Caller890/STM32H747IGT6-Custom-Development-Board/Gerber/README.md

Gerber fabrication files for STM32H747IGT6 Development Board
