Caller890/STM32H747IGT6-Custom-Development-Board/images/board_front.png

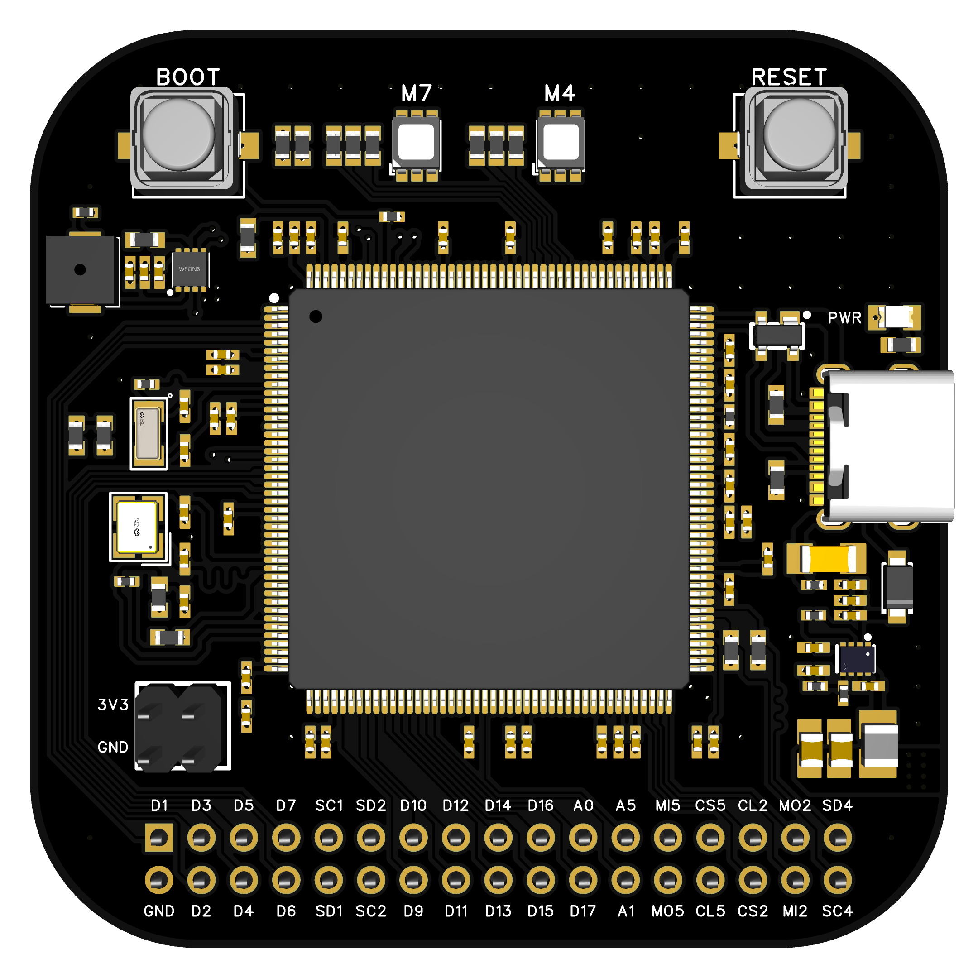
images/board_front.png
