Caller890/STM32H747IGT6-Custom-Development-Board/images/board_rear.png

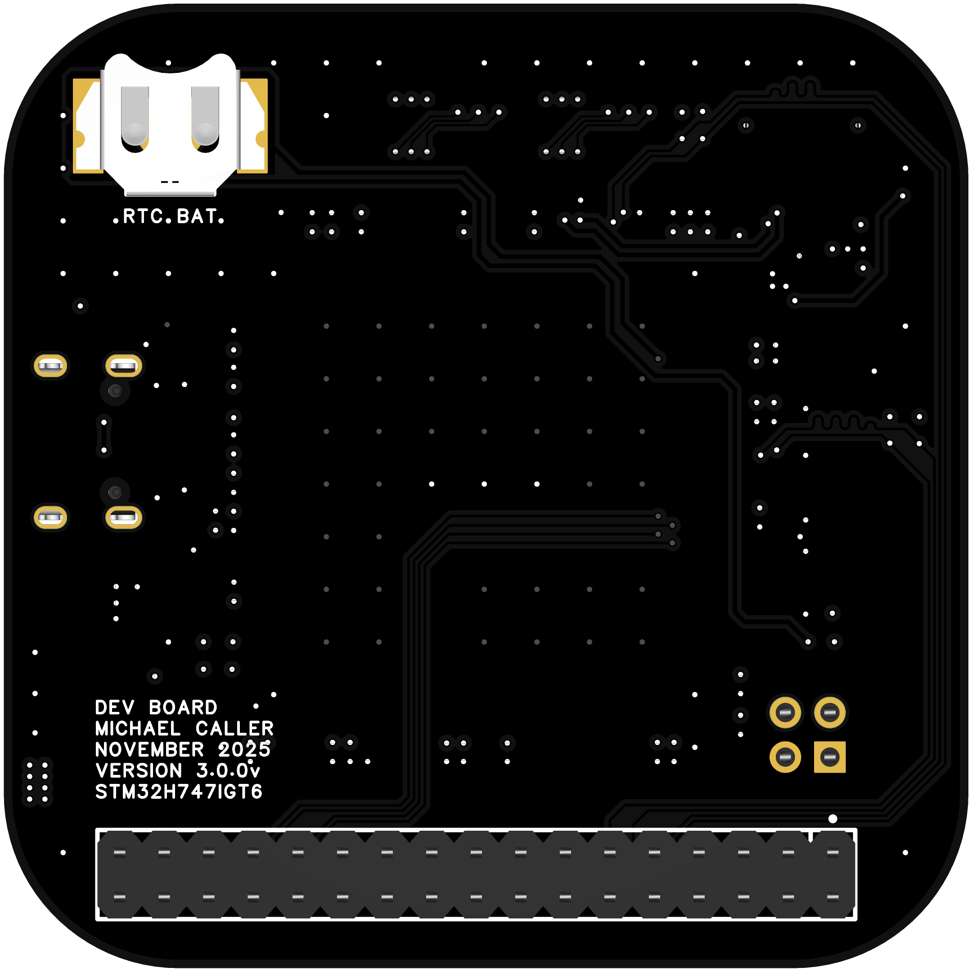
images/board_rear.png
