Caller890/STM32H747IGT6-Custom-Development-Board/images/gerber_front.png

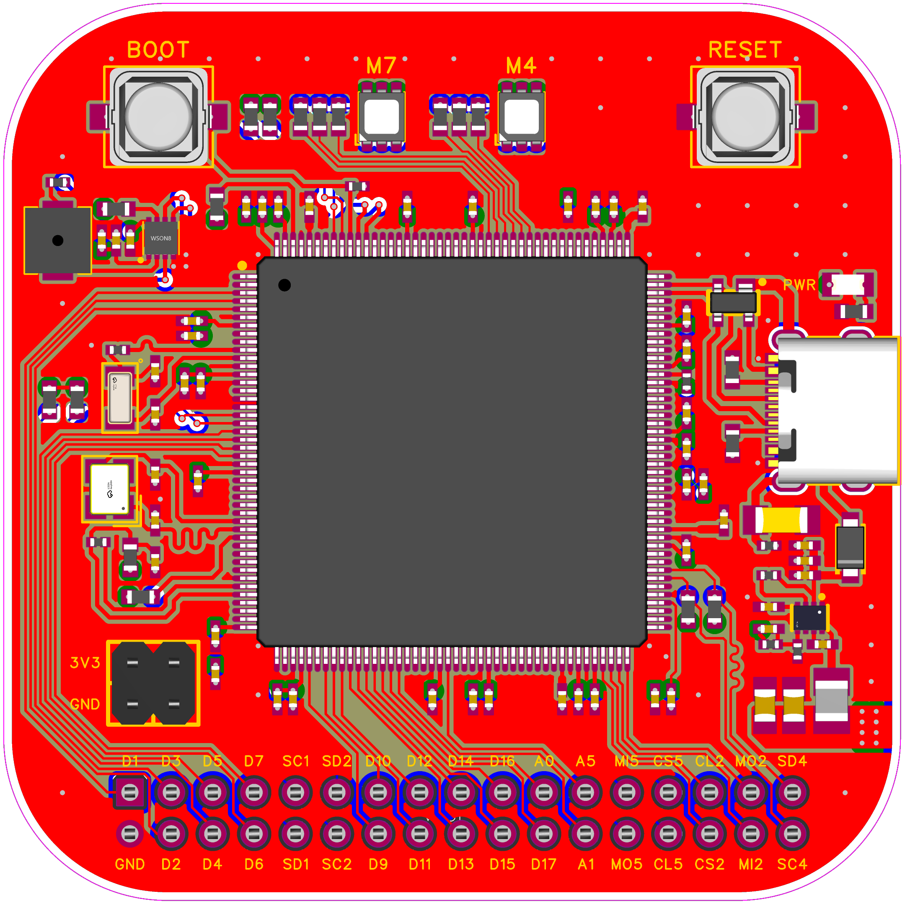
images/gerber_front.png
