Caller890/STM32H747IGT6-Custom-Development-Board/images/gerber_rear.png

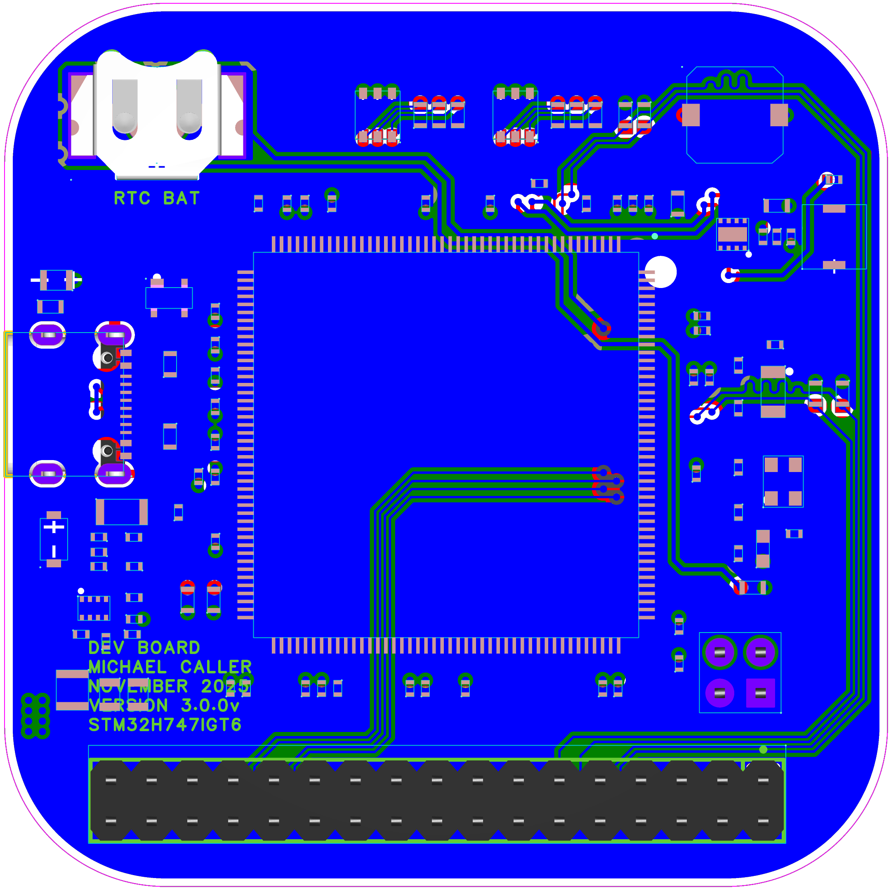
images/gerber_rear.png
