Caller890/STM32H747IGT6-Custom-Development-Board/images/normal_view.png

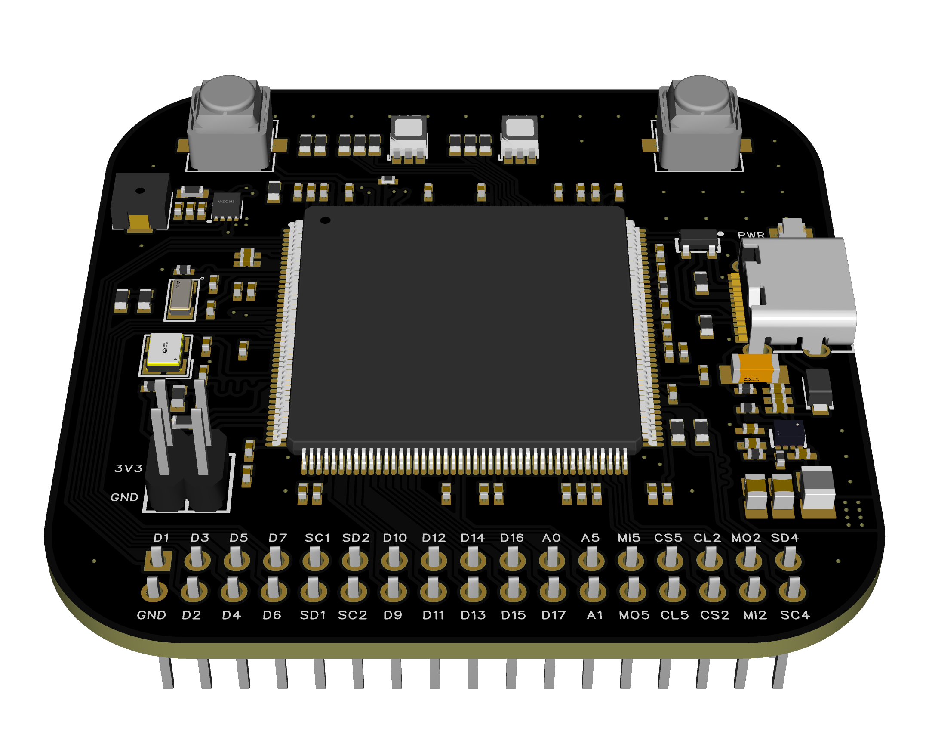
images/normal_view.png
