Caller890/STM32H747IGT6-Custom-Development-Board/Gerber/BOM_STM32H747IGT6_Custom_Dev_Board_Rev3.xlsx

No. | Quantity | Comment | Designator | Footprint | Value | Manufacturer Part | Manufacturer | Supplier Part | Supplier | Layer | Mounting Style | Name
1 | 2 | SPEH130103 | BOOT,RESET | SW-SMD_L6.0-W6.0-LS6.6 |  | SPEH130103 | ALPSALPINE | C390925 | LCSC | T | SMT | SPEH130103
2 | 1 | MY-621-01 | BT1 | BAT-SMD_MY-621-01 |  | MY-621-01 | MYOUNG | C5460241 | LCSC | B | SMT | MY-621-01
3 | 1 | 4kHz | BUZZER | BUZ-SMD_2P-L4.0-W4.0-L_GSC4317YA | 4kHz | GSC4417YA-16R4000 | INGHAi | C255308 | LCSC | T | SMT | 4kHz
4 | 1 | 4.7nF | C9 | C1206 | 4.7nF | CC1206KKX7RCBB472 | YAGEO | C107198 | LCSC | T | SMT | 4.7nF
5 | 5 | 2.2uF | C10,C11,C12,C15,C54 | C0402 |  | CC0402KRX5R8BB225 | YAGEO | C723363 | LCSC | T | SMT | 2.2uF
6 | 12 | 10uF | C16,C18,C19,C20,C21,C22,C23,C24,C25,C52,C53,C64 | C0402 | 10uF | CC0402MRX5R6BB106 | YAGEO | C962143 | LCSC | T | SMT | 10uF
7 | 27 | 100nF | C27,C28,C29,C30,C31,C32,C33,C34,C35,C36,C37,C38,C39,C40,C41,C42,C43,C44,C45,C46,C47,C48,C51,C55,C59,C65,C66 | C0402 | 100nF | CC0402JRX7R8BB104 | YAGEO | C541465 | LCSC | T | SMT | 100nF
8 | 2 | 10pF | C49,C50 | C0402 | 10pF | CC0402FRNPO9BN100 | YAGEO | C513681 | LCSC | T | SMT | 10pF
9 | 1 | 22pF | C58 | C0402 | 22pF | CC0402FRNPO9BN220 | YAGEO | C277482 | LCSC | T | SMT | 22pF
10 | 2 | 10uF | C60,C61 | C0805 | 10uF | CC0805KKX5R8BB106 | YAGEO | C89831 | LCSC | T | SMT | 10uF
11 | 2 | 9pF | C62,C63 | C0402 | 9pF | CC0402CRNPO9BN9R0 | YAGEO | C282242 | LCSC | T | SMT | 9pF
12 | 1 | PMEG6020AELRX | D1 | SOD-123_L2.6-W1.7-LS3.5-RD |  | PMEG6020AELRX | Nexperia | C552938 | LCSC | T | SMT | PMEG6020AELRX
13 | 1 | X6521WV-2x17H-C60D30 | H2 | HDR-TH_34P-2.54-V-M-R2-C17-S2.54 |  | X6521WV-2x17H-C60D30 | XKB Connection | C725889 | LCSC | B | DIP | X6521WV-2x17H-C60D30
14 | 1 | 47µH | L1 | L0603 |  | LQM18DH470M70L | Murata Electronics | 490-LQM18DH470M70LCT-ND | Digi-Key | T | SMT | 47µH
15 | 1 | 3.3uH | L2 | L1008 | 3.3uH | MIP25203R3MBE | INPAQ | C315720 | LCSC | T | SMT | 3.3uH
16 | 1 | LTST-C170TGKT | LED3 | LED0805-R-RD_GREEN |  | LTST-C170TGKT | LITEON | C364562 | LCSC | T | SMT | LTST-C170TGKT
17 | 2 | ASMT-YTD7-0AA02 | LED4,LED5 | LED-ARRAY-SMD_6P-L3.0-W2.8-P0.90-LS3.4-BR |  | ASMT-YTD7-0AA02 | Broadcom | C3018557 | LCSC | T | SMT | ASMT-YTD7-0AA02
18 | 1 | STM32H747IGT6 | MCU1 | LQFP-176_L24.0-W24.0-P0.50-LS26.0-BL |  |  |  |  |  | T | SMT | STM32H747IGT6
19 | 2 | 22Ω | R1,R13 | R0603 | 22Ω | RC0603FR-0722RL | YAGEO | C107701 | LCSC | T | SMT | 22Ω
20 | 2 | 976kΩ | R3,R38 | R0402 | 976kΩ | AC0402DR-07976KL | YAGEO | C226736 | LCSC | T | SMT | 976kΩ
21 | 8 | 5.1kΩ | R4,R6,R25,R26,R27,R28,R36,R37 | R0603 | 5.1kΩ | RC0603JR-075K1L | YAGEO | C14677 | LCSC | T | SMT | 5.1kΩ
22 | 2 | 20Ω | R8,R17 | R0603 | 20Ω | RC0603FR-0720RL | YAGEO | C125758 | LCSC | T | SMT | 20Ω
23 | 2 | 120Ω | R10,R18 | R0603 | 120Ω | RC0603FR-07120RL | YAGEO | C114640 | LCSC | T | SMT | 120Ω
24 | 1 | 0Ω | R16 | R0402 | 0Ω | RC0402JR-070RL | YAGEO | C60485 | LCSC | T | SMT | 0Ω
25 | 1 | 330Ω | R19 | R0402 | 330Ω | RC0402FR-07330RL | YAGEO | C105875 | LCSC | T | SMT | 330Ω
26 | 3 | 100kΩ | R21,R23,R42 | R0603 | 100kΩ | RC0603FR-07100KL | YAGEO | C14675 | LCSC | T | SMT | 100kΩ
27 | 1 | 0Ω | R22 | R0402 | 0Ω | RC0402FR-070RL | YAGEO | C106231 | LCSC | T | SMT | 0Ω
28 | 1 | 1kΩ | R24 | R0402 | 1kΩ | RC0402FR-071KL | YAGEO | C106235 | LCSC | T | SMT | 1kΩ
29 | 1 | 100kΩ | R29 | R0402 | 100kΩ | RC0402FR-07100KL | YAGEO | C60491 | LCSC | T | SMT | 100kΩ
30 | 1 | 220kΩ | R35 | R0402 | 220kΩ | RC0402FR-07220KL | YAGEO | C138030 | LCSC | T | SMT | 220kΩ
31 | 1 | 330Ω | R41 | R0603 | 330Ω | RC0603JR-07330RL | YAGEO | C105879 | LCSC | T | SMT | 330Ω
32 | 1 | 20Ω | R43 | R0402 | 20Ω | RC0402FR-0720RL | YAGEO | C138031 | LCSC | T | SMT | 20Ω
33 | 1 | PRTR5V0U2X | U3 | SOT-143_L2.9-W1.3-P1.92-LS2.3-BR |  |  |  |  |  | T | SMT
34 | 1 | MP2322GQH | U6 | VSON-8_L2.0-W1.5-P0.50-BL |  | MP2322GQH |  | C2764990 | LCSC | T | SMT | MP2322GQH
35 | 1 | BX-PZ2.54-2-2PZZ | U7 | HDR-TH_4P-P2.54-V-M-R2-C2-S2.54 |  | BX-PZ2.54-2-2PZZ | Bossie | C18078211 | LCSC | T | DIP | BX-PZ2.54-2-2PZZ
36 | 1 | DRV8210DSGR | U9 | WSON-8_L2.0-W2.0-P0.50-BL-EP_DSG |  | DRV8210DSGR | TI | C3681199 | LCSC | T | SMT | DRV8210DSGR
37 | 1 | TYPE-C-31-M-12 | USBC1 | USB-C_SMD-TYPE-C-31-M-12 |  |  |  | C165948 | LCSC | T | DIP | TYPE-C-31-M-12
38 | 1 | 16MHz | X1 | CRYSTAL-SMD_4P-L3.2-W2.5-BL | 16MHz | X322516MMB4SI | YXC | C112972 | LCSC | T | SMT | 16MHz
39 | 1 | CM315D32768DZFT | Y1 | OSC-SMD_2P-L3.2-W1.5 |  |  | CITIZEN | C182057 | LCSC | T | SMT | CM315D32768DZFT
