Caller890/STM32H747IGT6-Custom-Development-Board/Schematic/STM32H747IGT6_Custom_Dev_Board_Rev3.pdf

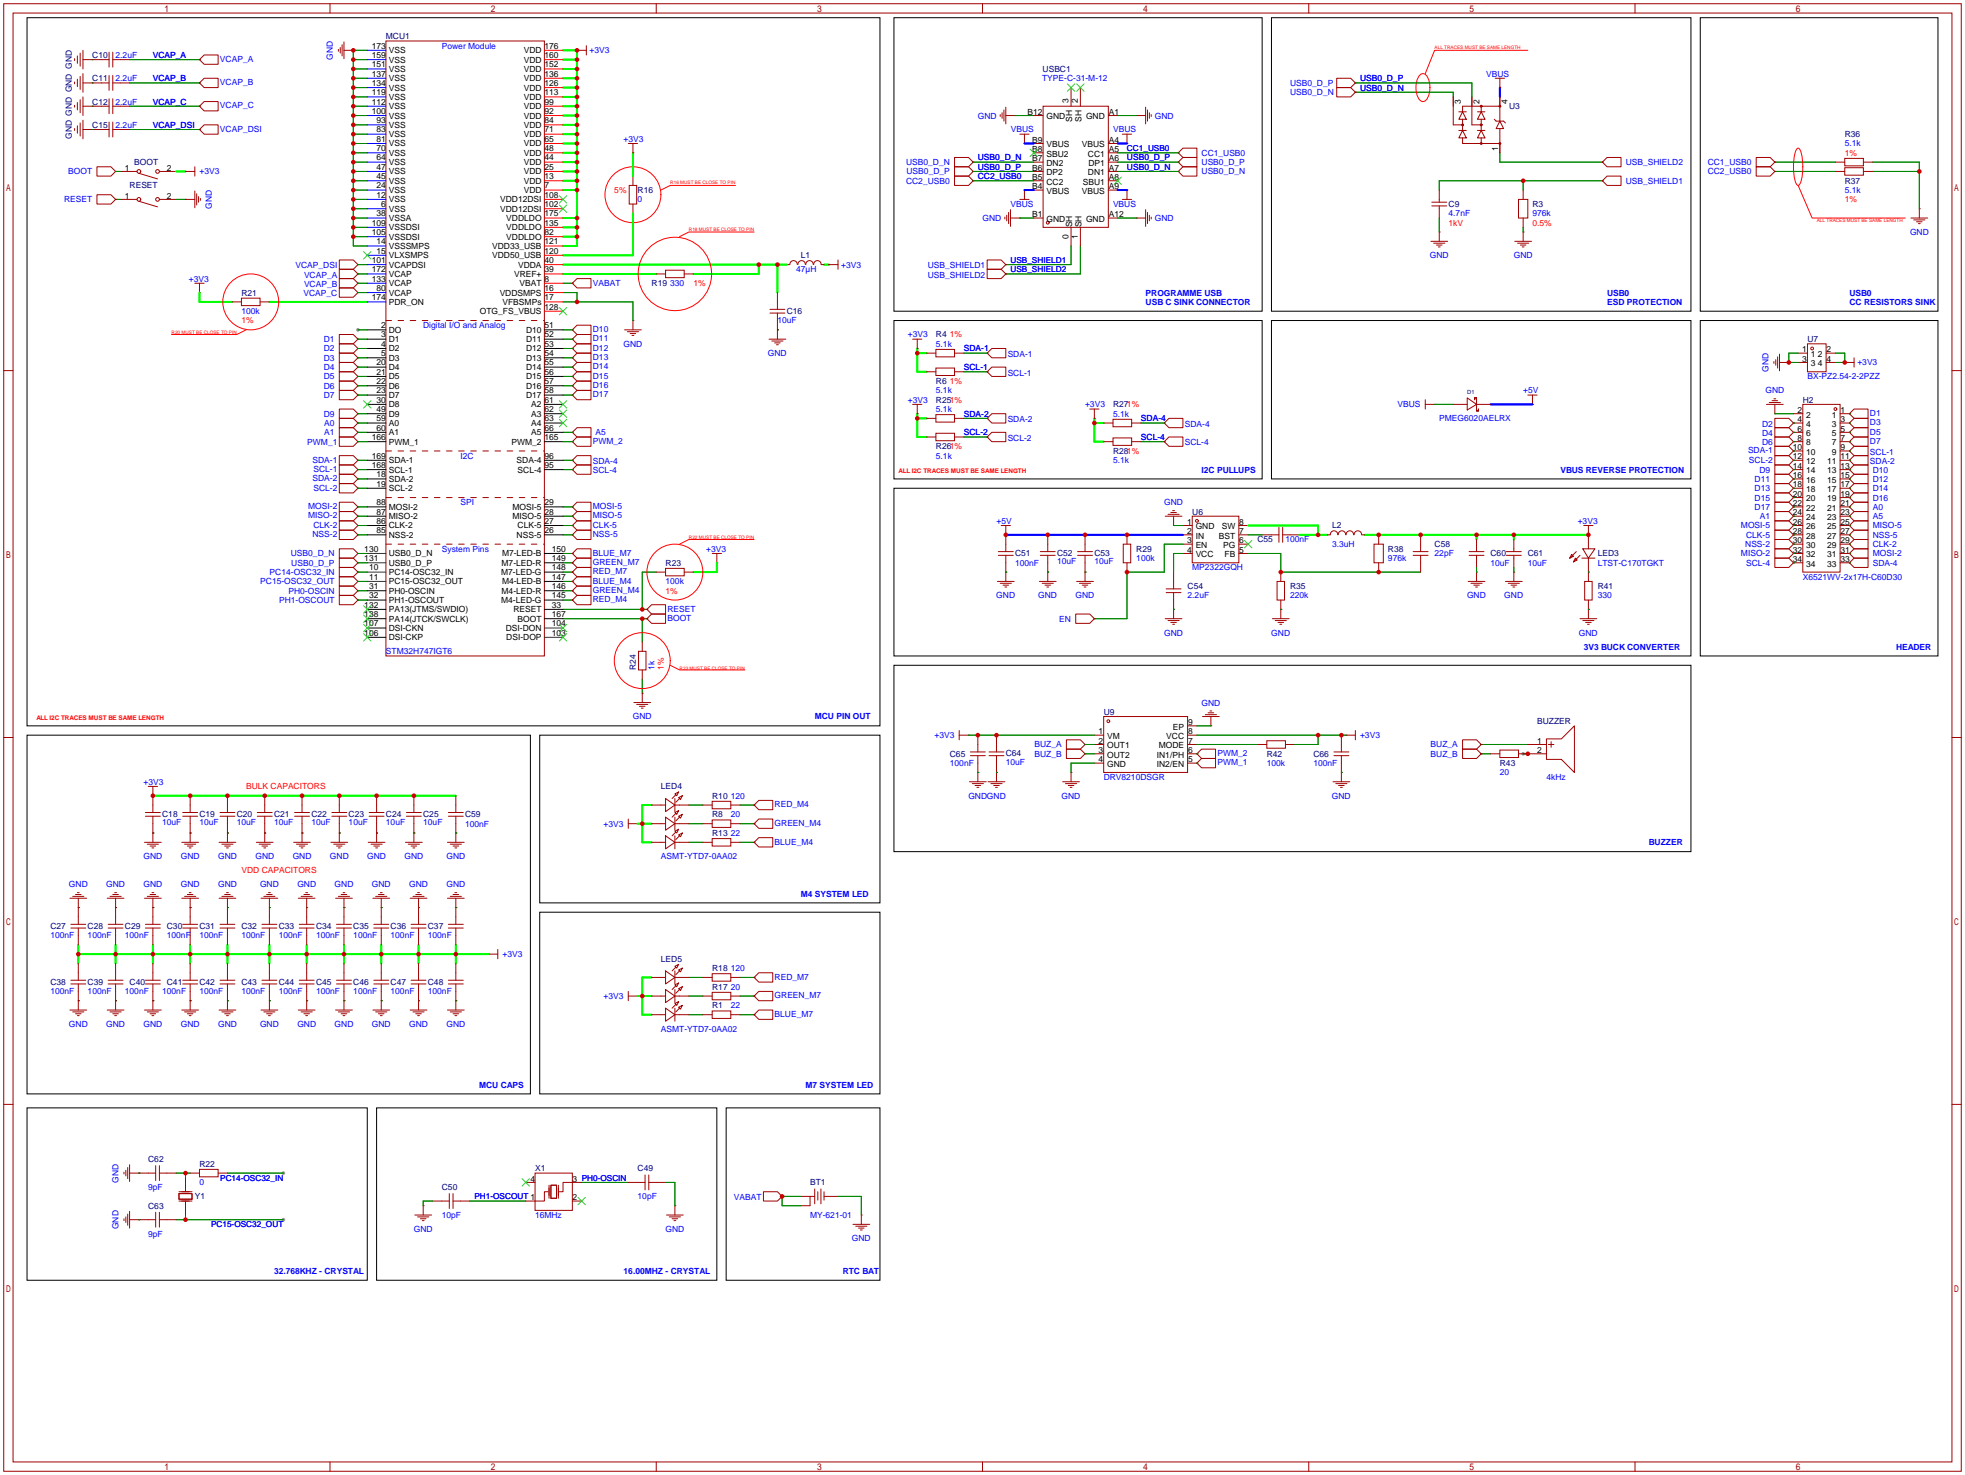
[picture p6: page 1]

ALL TRACES MUST BE SAME LENGTH

R18 MUST BE CLOSE TO PIN

R20 MUST BE CLOSE TO PIN

ALL I2C TRACES MUST BE SAME LENGTH

R22 MUST BE CLOSE TO PIN

R23 MUST BE CLOSE TO PIN
