Caller890/STM32H747IGT6-Custom-Development-Board/(commit log)

2025-11-11 Add board images to README
2025-11-11 Update README to use board_front.png
2025-11-11 Add board_rear.png to Images folder
2025-11-11 Add gerber_front, gerber_rear, and normal_view images
2025-11-12 Add placeholder README for Schematic folder
2025-11-12 Add STM32H747IGT6 schematic PDF
2025-11-12 Add Gerber folder README
2025-11-12 Add Gerber fabrication files (BOM, Pick & Place, ZIP)
    [BOM_STM32H747IGT6_Custom_Dev_Board_Rev3.xlsx, Pick_Place_STM32H747IGT6_Custom_Dev_Board_Rev3.xlsx]
2025-11-12 Remove Gerber_BMS_Avinoics_2.0.1v_2025-11-12.zip file
2025-11-12 Add Gerber_STM32H747IGT6_Custom_Dev_Board_Rev3.zip file
2025-11-12 Update README with Gerber section and images
2025-11-12 Fix board_front image link
