Caller890/STM32H747IGT6-Custom-Development-Board/(notices)

Notices in the files:
Master_Template_Board/CM4/Core/Src/main.c:
Copyright (c) 2025 STMicroelectronics.
All rights reserved.
This software is licensed under terms that can be found in the LICENSE file
